SJohnston95/2.4Ghz-SMD-filter/20180318_172855.jpg

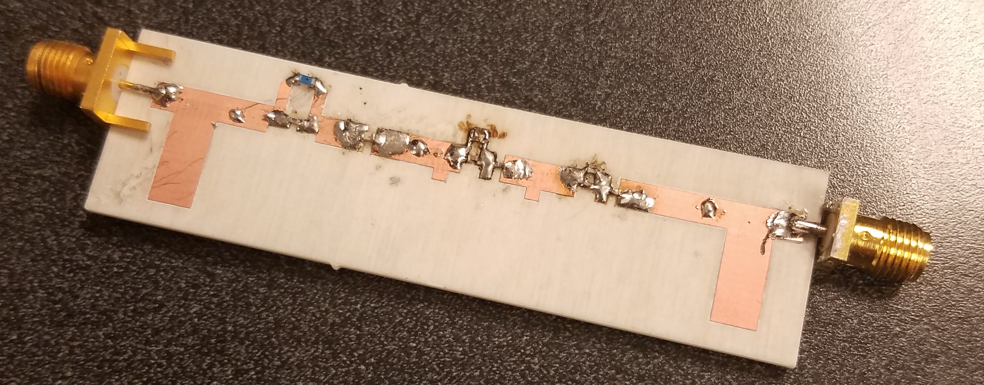
20180318_172855.jpg
