SJohnston95/2.4Ghz-SMD-filter/Pyle_Johnston_Zodrow_ECE431_Filter_Paper_Final.pdf

ECE 431/531 Winter 2018 Final Project Mitch Pyle
Stephen Johnston
Dylan Zodrow
Characterizing the Substrate

In order to design a great filter in the microwave spectrum small details become increasingly important. A distributed element filter relies heavily on the characteristics of the substrate. Thankfully using ADS we can model these characteristics and change them easily. There are many options in ADS, but the basic simulation in ADS requires us to know the conductivity, height, thickness and relative permittivity.

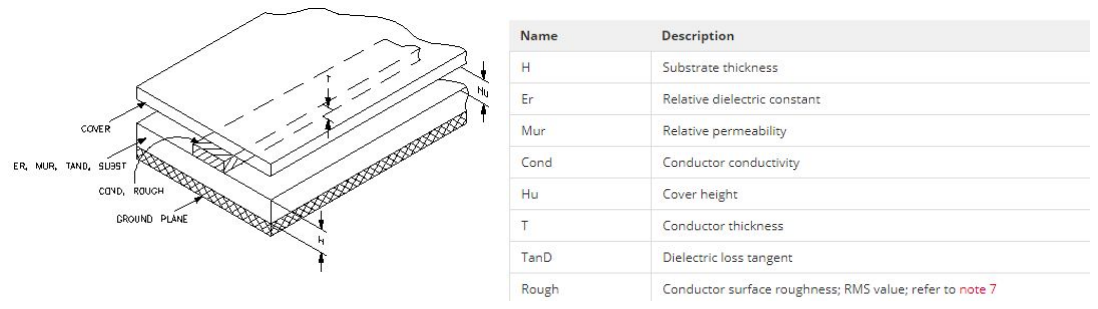
[picture p2: figure]

Figure 1 – ADS MSub Parameters[5]

Fortunately the sample we obtained from Rogers Corporation has a very detailed datasheet. [6]

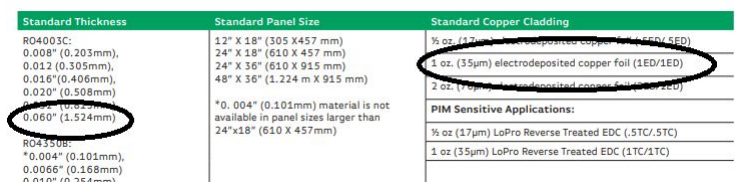
[picture p3: figure]

Figure 2 – Rogers R04003C Datasheet

Figure 3- Properties of Copper [3][4]

Design, Build, and Test Calibration Structures

Many of the characteristics of the substrate can be obtained from the datasheet, but as engineers we need to know how these characteristic information is obtained. Using ADS we will attempt to make our own estimate of the relative permittivity of our substrate. Using a parallel distributed element structure we will see some dramatic changes in the S21 at specific frequencies. Simulating the circuit and measuring the circuit with the VNA should give us an estimate of the actual effective permittivity.

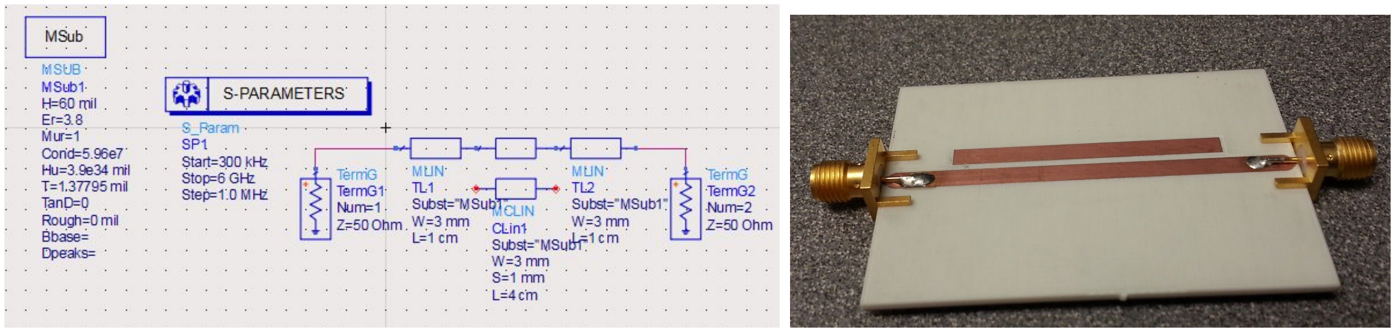
[picture p4: figure]

Figure 4- ADS Simulation and Actual Parallel Resonant Circuit

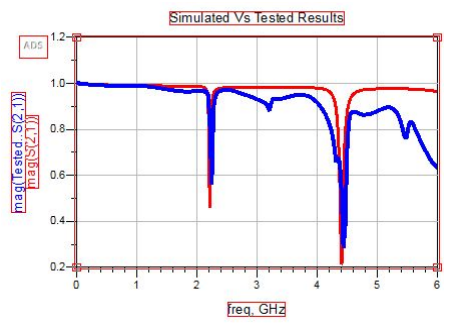
[picture p5: figure]

Figure 5- Measured and Simulated Results

TRL Calibration Board Design

All measurements will be done using a Vector Network Analyzer (VNA), which requires calibration prior to taking measurements. Proper calibration of the VNA requires the use of three references: Through, reflect, and line (TRL). The through connection is the two SMA terminals connected by a small transmission line, this is normalization reference. The reflect connection consists of two SMA connectors with a gap of λ/4, or at 1 GHz in a copper trace about 22.8 mm. The line connection consists of two SMA connectors connected by a λ/4 section of TL line.

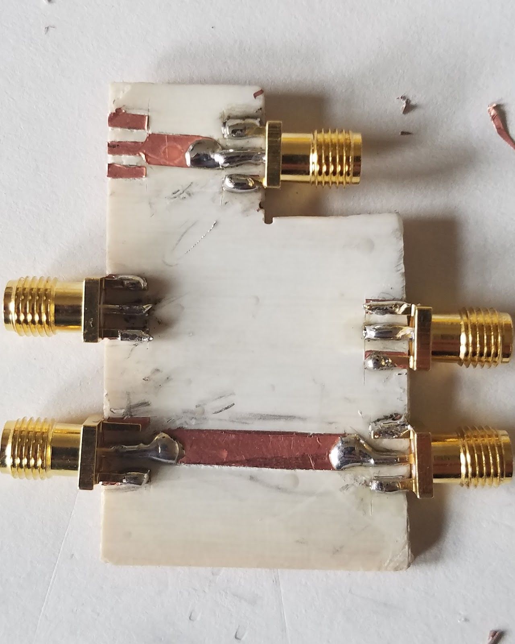
[picture p6: figure]

Figure 7- Constructed TRL Board (Mostly complete)

Clearly, since measurements are given in terms of λ, a TRL Board is only good for a given frequency, ior small range. Once the board is constructed, the calibration is performed by defining a Cal Kit in the VNA software. This is done by defining the frequency range of measurement and assigning the through, reflect, and line measurements. For each connection all 4 S parameters are measured, and using these 12 measurements the VNA uses a set of equations to calculate 10 of the 12 error (it not being possible to calculate the forward and the reverse isolations terms with the available data). With these numbers saved as a Cal Kit, it is then possible to apply these settings when taking a measurement of, say, a filter design.

“Paper” Design

The only requirement for our filter is the graph below. Looking at the graph we can see that the insertion loss should be -4dB at the center frequency of 2.6 or 2.4 GHz. It is important to also notice that both filters have a roll-off of 40 dB for 100 MHz on either side. I would also venture to say that the filter has a perfectly flat passband for 100 MHz around the center frequency.

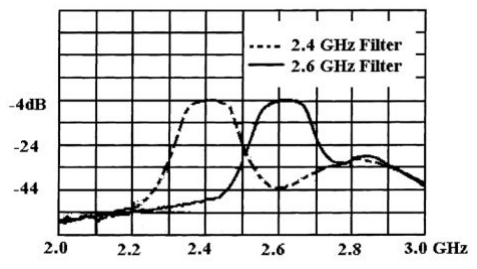
[picture p7: figure]

Figure 8- Filter Requirements

Distributed Element Filter

Designing the distributed element filter was greatly facilitated by ADS. I had seen pictures of similar filters [7] and knew I would need a parallel resonant element. I initially used a single element and 50 ohm strips to solder on the connections. I used ADS’s tuning option to fit the length, width, and separation to our desired frequency range with a single element. This gave me a filter with a very large bandpass. The roll-off was not enough with a single element. I added more elements in series effectively adding more stages and increasing the roll-off.

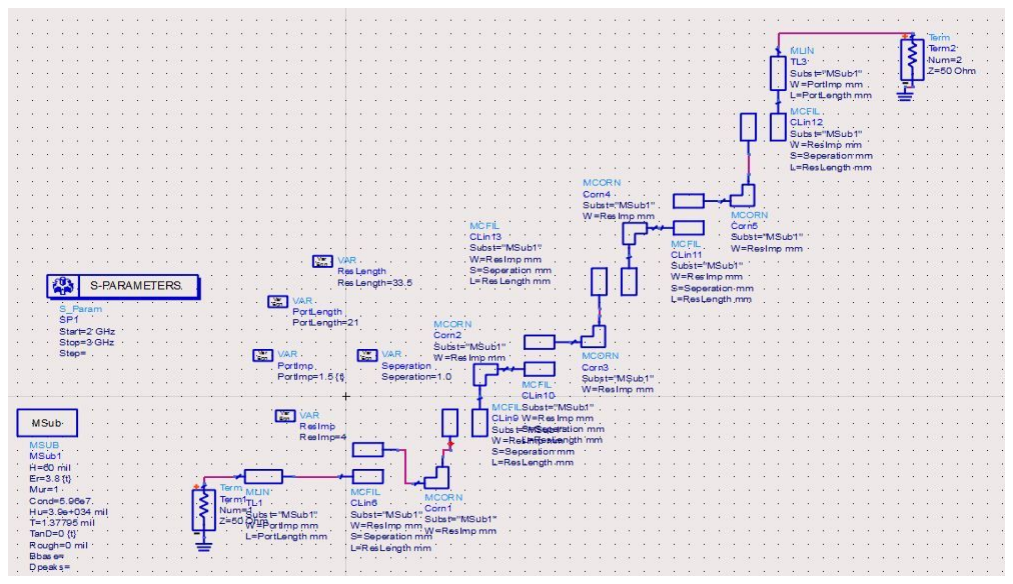
[picture p8: figure]

Figure 9- ADS Simulation of the Distributed Element Filter

My initial success was far too large to print on one sample of substrate. I used corner pieces in an effort to make my design more compact. As you can see from the figure below I tuned the whole circuit with a handful of variables. I knew it would be hard to realize, so I only incremented things in .5 millimeter increments. After hours of tuning I came up with my final design. A very simple design that could be cut by hand. The smallest measurement was 1.5 mm.

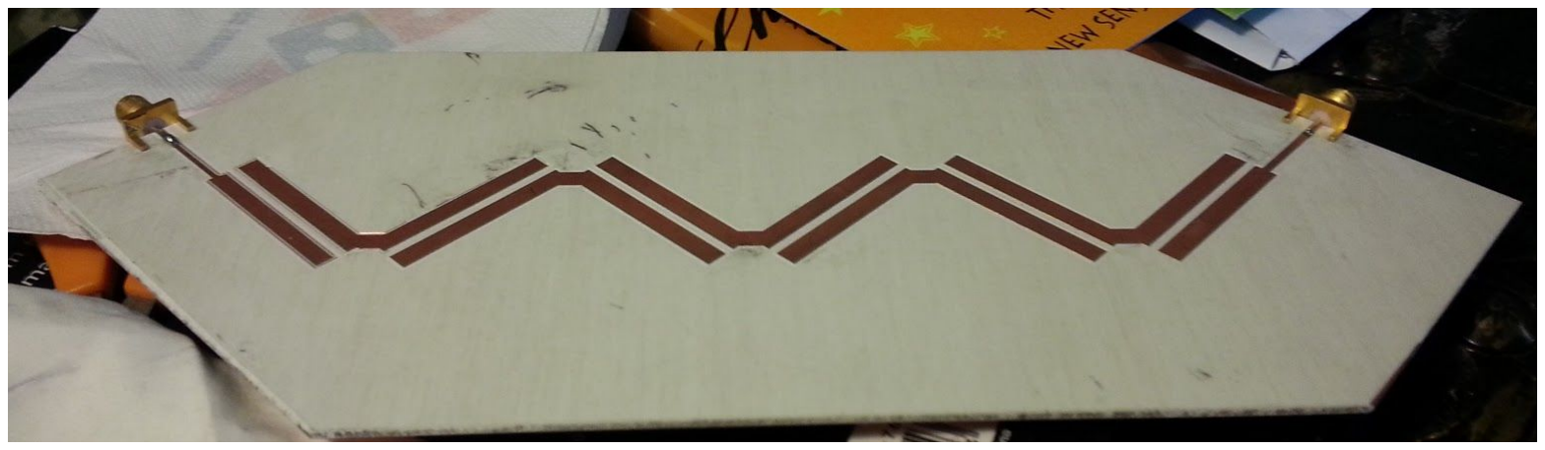
[picture p9: figure]

Figure 10- The Final Distributed Element Circuit

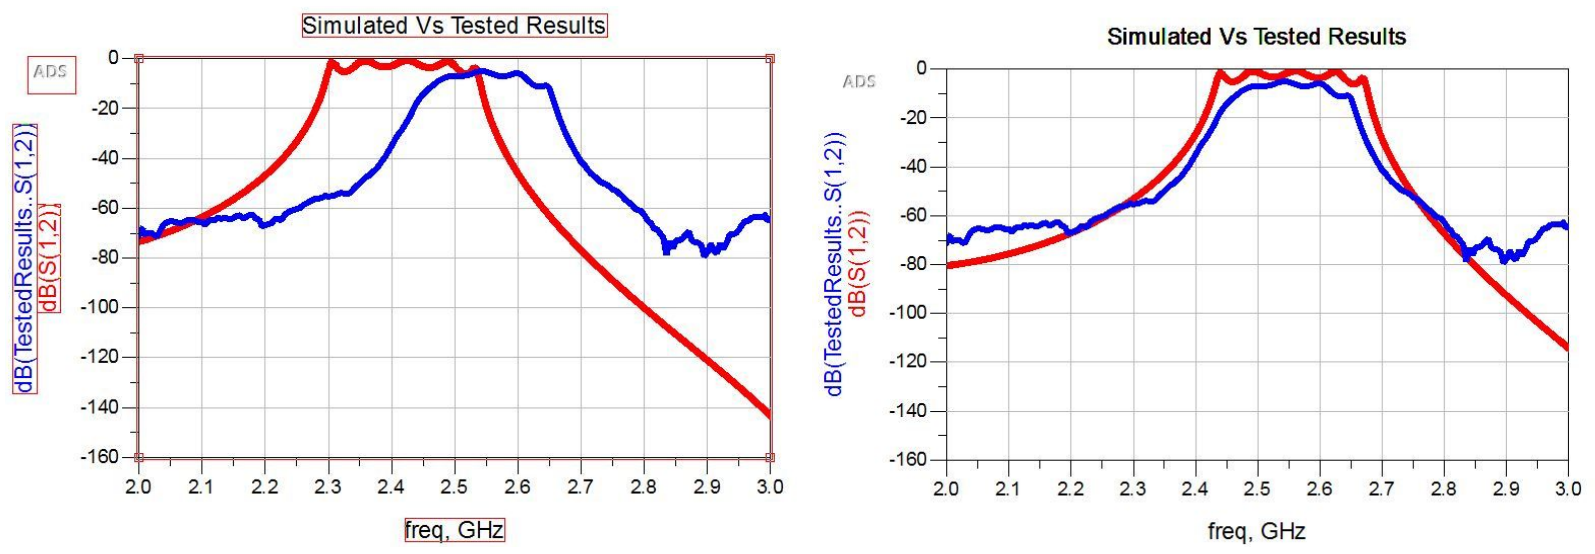
[picture p10: figure]

Figure 9- Comparison of Tested and Simulated Results and Adjusted Effective Permittivity

Results

Again using ADS i was able to discover the largest difference between simulation and reality. I used the tuning feature of ADS to adjust the Er of my substrate to 3.3 and the outputs were nearly identical. The insertion loss may be due to the input terminal strips a bit less than 50 ohms. I made them this way intentionally because it seemed to improve insertion loss in the simulation. Also a router issue made one input terminal strip just a tiny bit smaller than the other. The next prototype would be much closer to the expected result. An Er of 3.3 is close to the datasheet specs from Rogers as well.

SMD filter

When the filter was first designed, we followed the standard chebyshev design process. First we design the equivalent low pass filter, determining the cutoff frequency, attenuation and necessary components. Then we convert it into a bandpass filter with the equations listed below.

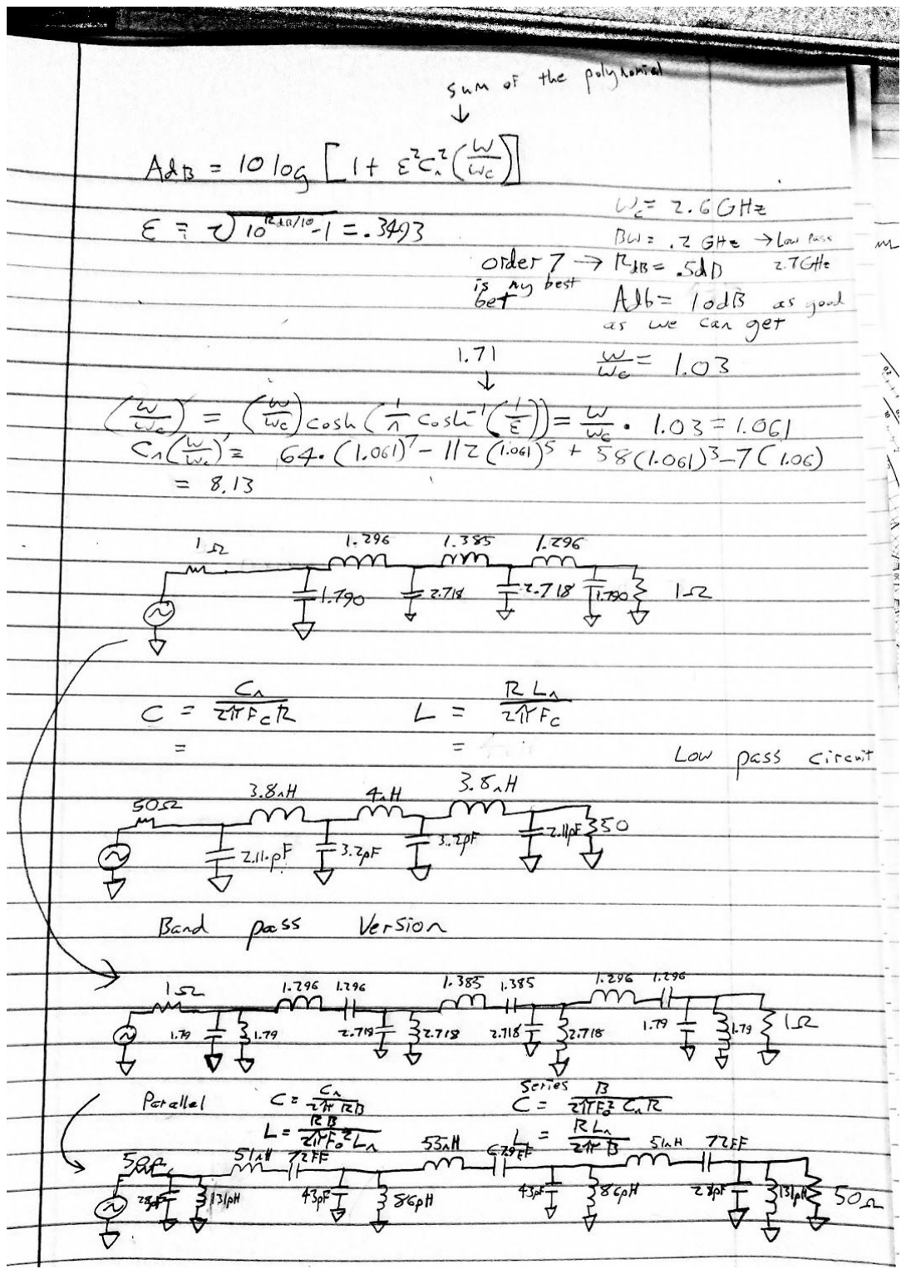
[picture p11: figure]

Figure 11- Paper Calculations for the SMD 2.6 GHz Filter

Figure 12- ADS Initial SMD Filter Simulation

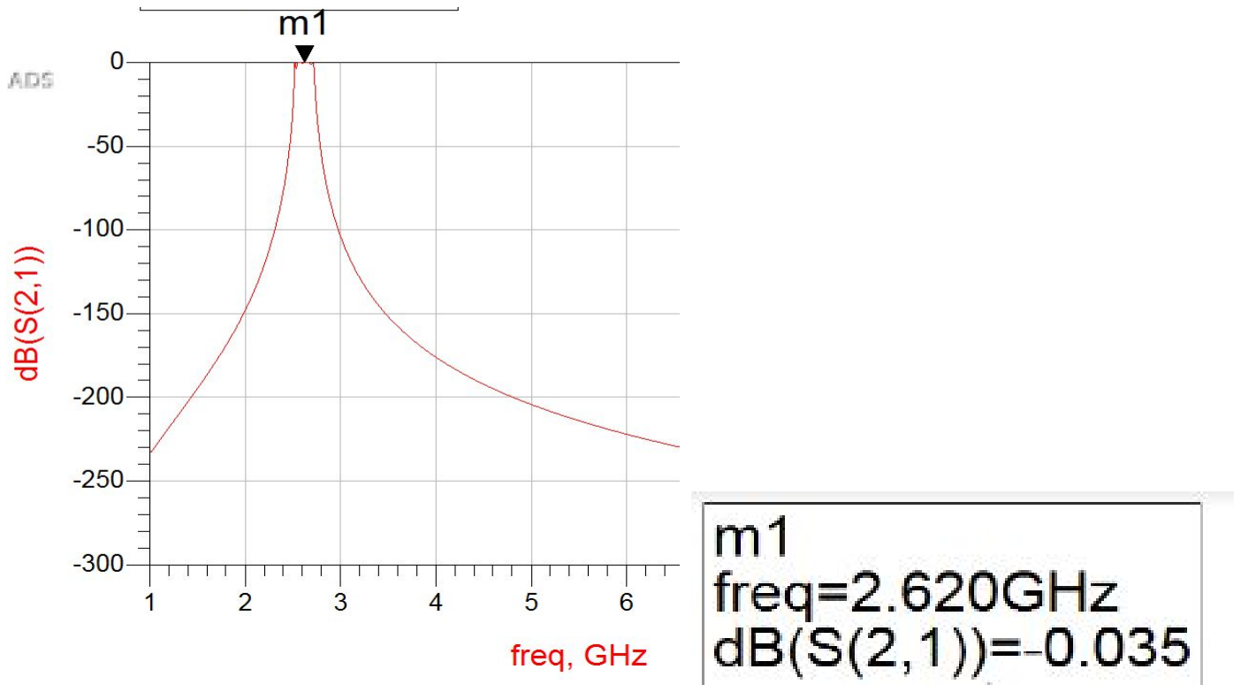
[picture p12: figure]

Figure 13- Results of Initial SMD Filter Simulation

But the problem is that these components don’t actually exist. Nothing is perfect and circuits are no exception, we need more accurate simulations before we can build anything of this magnitude.

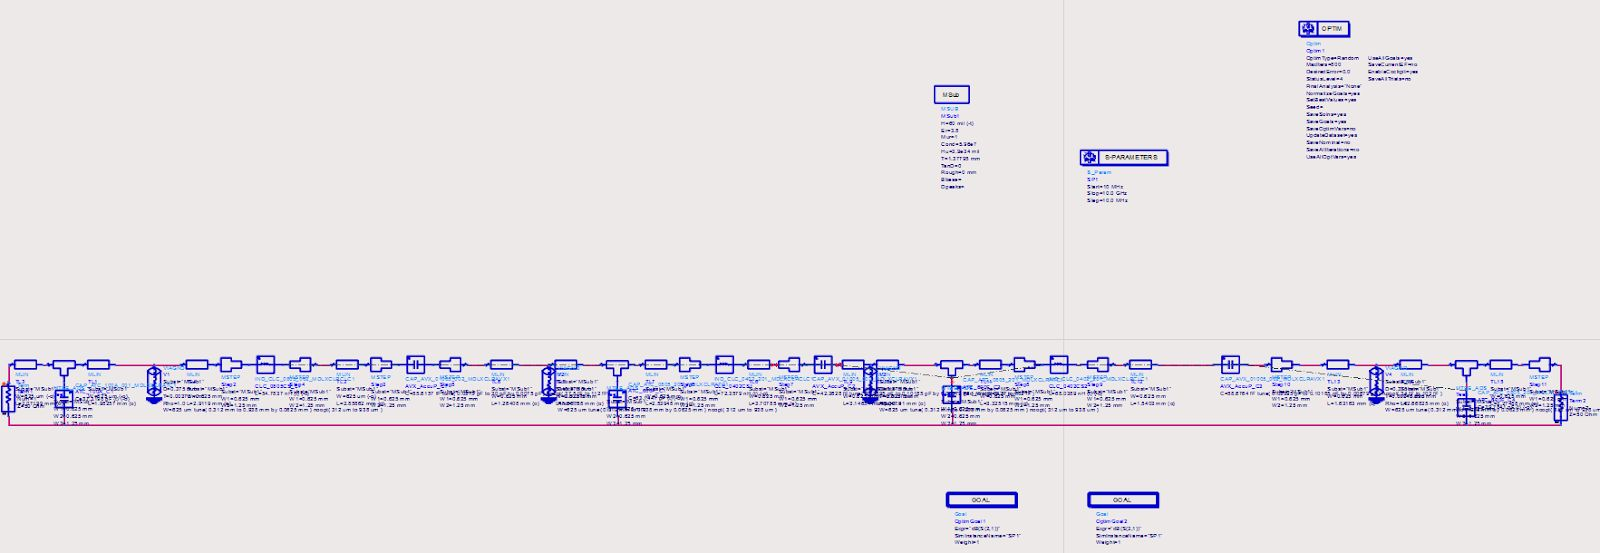
[picture p13: figure]

Figure 14- ADS SMD Filter Simulation with Added Microstrip Pads and Connections

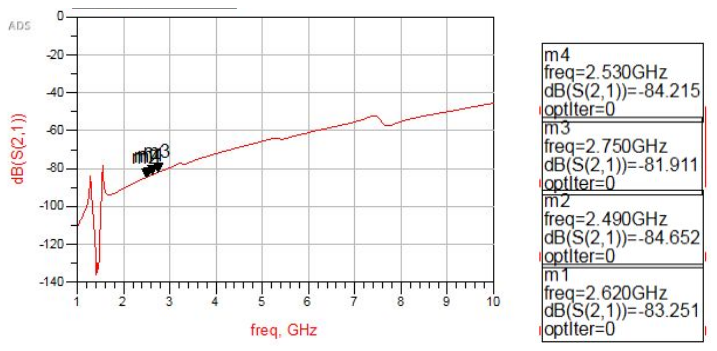
[picture p14: figure]

Figure 15- ADS Results

EVERYTHING IS RUINED. Unfortunately so. Our band pass filter that worked so perfectly under perfect conditions broke at the sign of stress. Luckily, we have an option. We can remove unreliable
components such as small inductors or capacitors to ground and replace them with vias and open circuit stubs, respectively. And run the optimization function, sometimes for hours. Until the response slowly and surely begins to look more and more like a filter

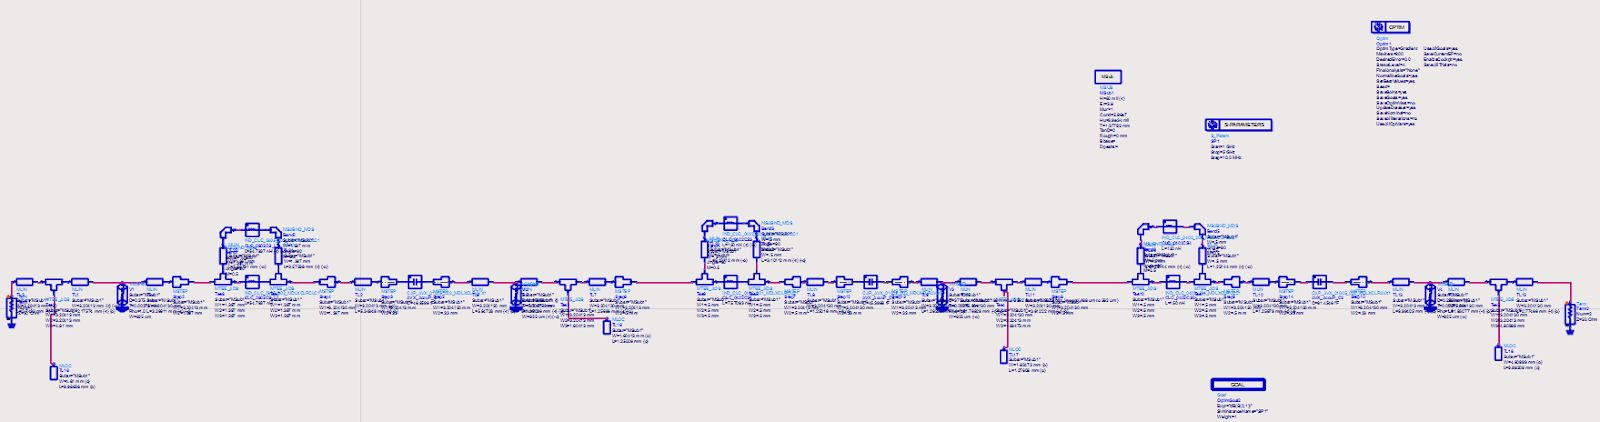
[picture p15: figure]

Figure 17- ADS Simulation of Distributed Element / SMD Hybrid

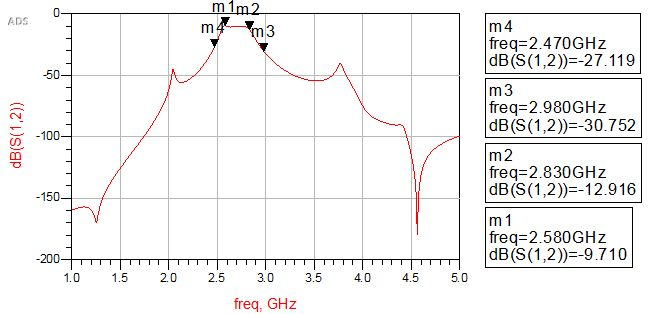
[picture p16: figure]

Figure 18- ADS Results of Distributed Element / SMD Hybrid

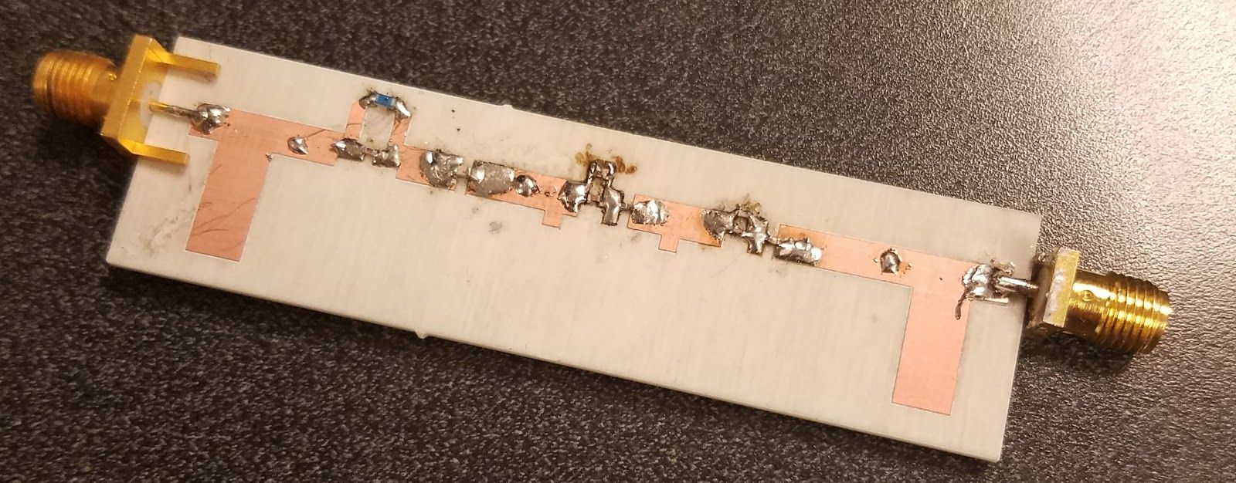
[picture p17: figure]

Figure 19- Realized SMD Filter

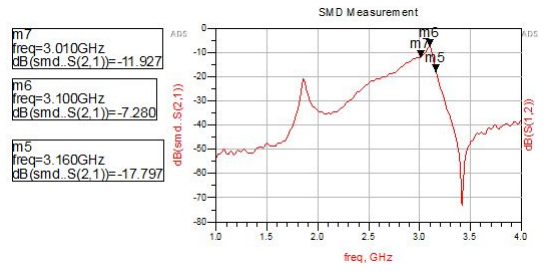
[picture p18: figure]

Figure 20- s(2,1) of the SMD Filter

Our output was not at all what we were hoping for. Due to the fact that the filter responds in the general frequency range, we have a large degree of hope for improvement. Possible failures include but definitely are not limited to

- SMD burn out
- Inexact substrate characterization
- Inexact conductivity of the copper and routing errors
- Solder improperly compensated for
- SMDS soldered on and not using a reflow oven

Further plans include compensating for SMD inductance by having more small open circuit stubs next to the component. This is because we can easily shave the stubs off to get the exact compensation for our SMD inductance. Other plans are using reflow ovens to exactly solder on with the least amount of solder.

References

[1]
C. Furse, R.J. Woodward, M.A. Jensen, “Laboratory Project in Wireless FSK Receiver Design,” IEEE Trans. Education, Vol. 47, no. 1, pp. 18-25, Feb. 2004.

[2]
Modelithics applications notes #17 “APPLICATION NOTE 017 “LUMPED ELEMENT FILTER DESIGN AND OPTIMIZATION”, #20 “LUMPED ELEMENT BAND-PASS FILTER DESIGN AND OPTIMIZATION.” Available at http://www.modelithics.com/literature.asp

[3]
Wikipedia “Permeability (Electromagnatism)” Available at https://en.wikipedia.org/wiki/Permeability_(electromagnetism)

[4]
Wikipedia “Electrical Resistivity and Conductivity” Available at https://en.wikipedia.org/wiki/Electrical_resistivity_and_conductivity

[5]
Keysights Technologies “MSUB (Microstrip Substrate)” Available at http://edadocs.software.keysight.com/pages/viewpage.action?pageId=5912136

[6]
Rogers Corporation “R04000 Laminates Data Sheets” Available at https://www.rogerscorp.com/acs/products/54/RO4003C-Laminates.aspx

[7]
Wikipedia “Distributed Element Filter” Available at https://en.wikipedia.org/wiki/Distributed_element_filter

[8]
Copper Mountain Technologies,”Fabricating and Using a PCB-Based TRL PAttern with aCMT VNA”, https://www.coppermountaintech.com/content/docs/library/Design_and_Fabrication_of_a_TRL_calibration_kit.pdf

[9]

Fleury, J. and Bernard, O. California Eastern Laboratories, “Design and Characterizing TRL Fixture Calibration Standards for Device Modeling”, http://www.cel.com/pdf/press/TRL.pdf
