SJohnston95/2.4Ghz-SMD-filter/20180303-163044_p0.jpg

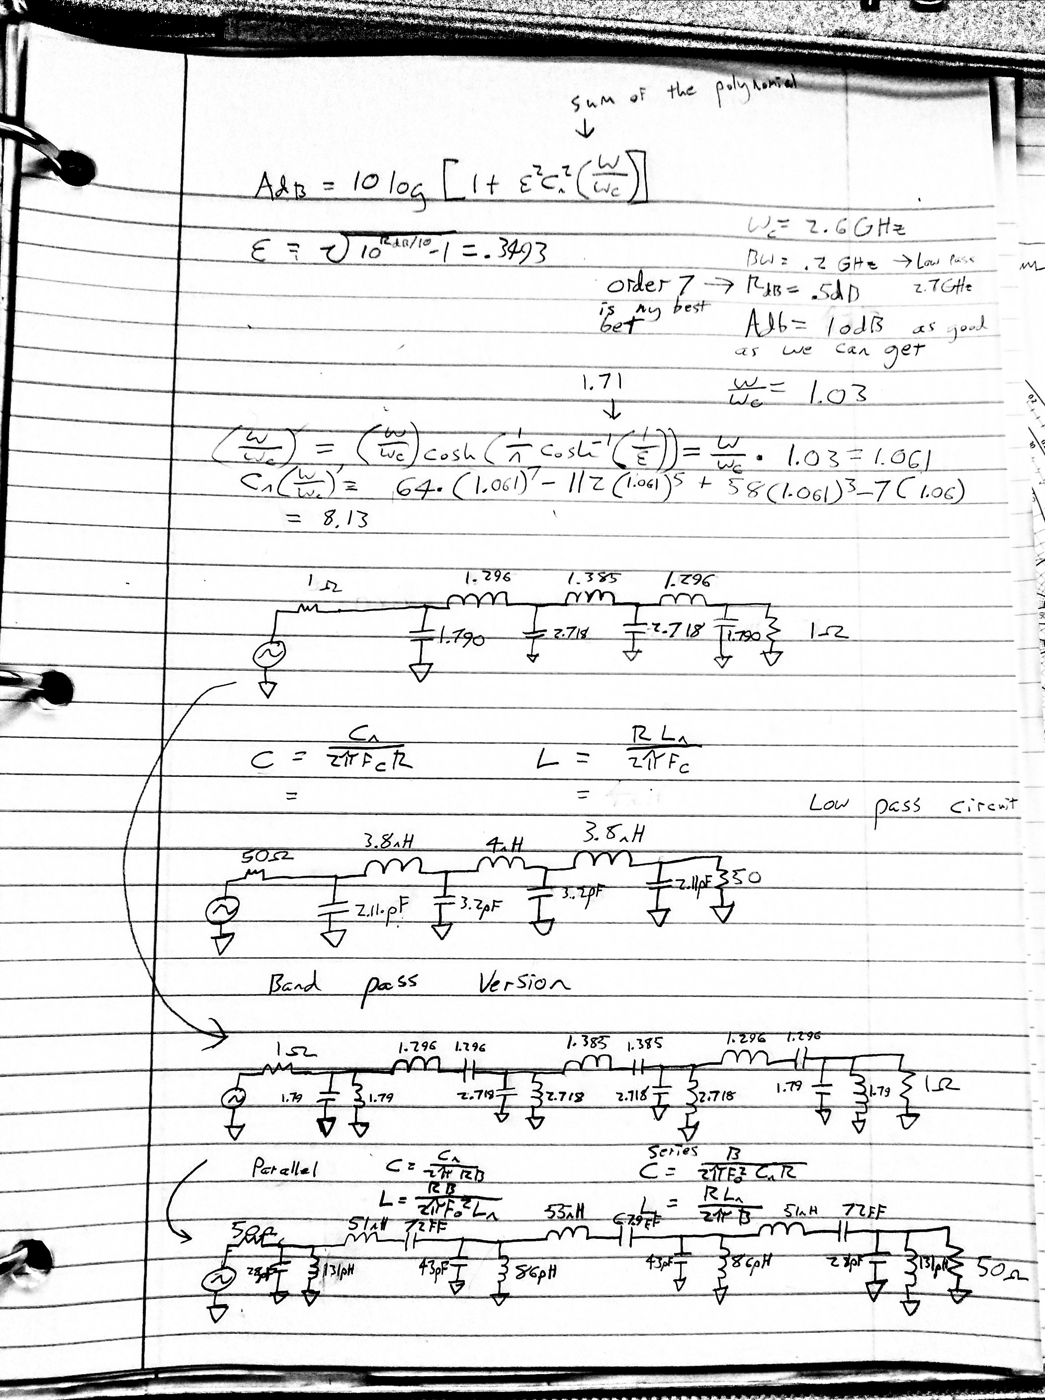
20180303-163044_p0.jpg
