SJohnston95/2.4Ghz-SMD-filter/filter.PNG

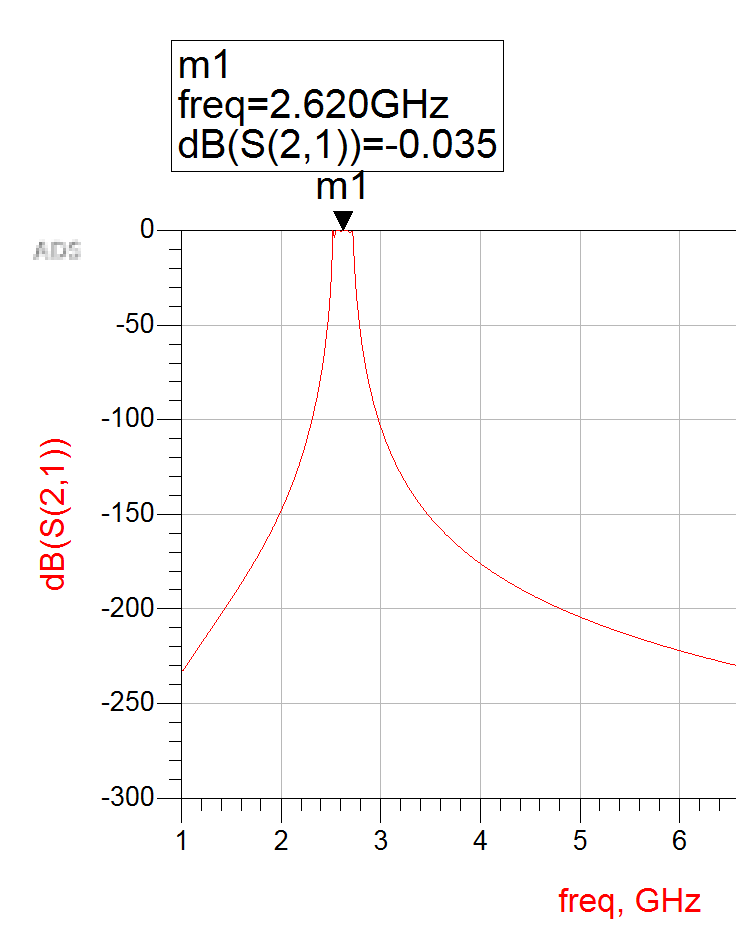
filter.PNG
