SJohnston95/2.4Ghz-SMD-filter/Filtersparam.PNG

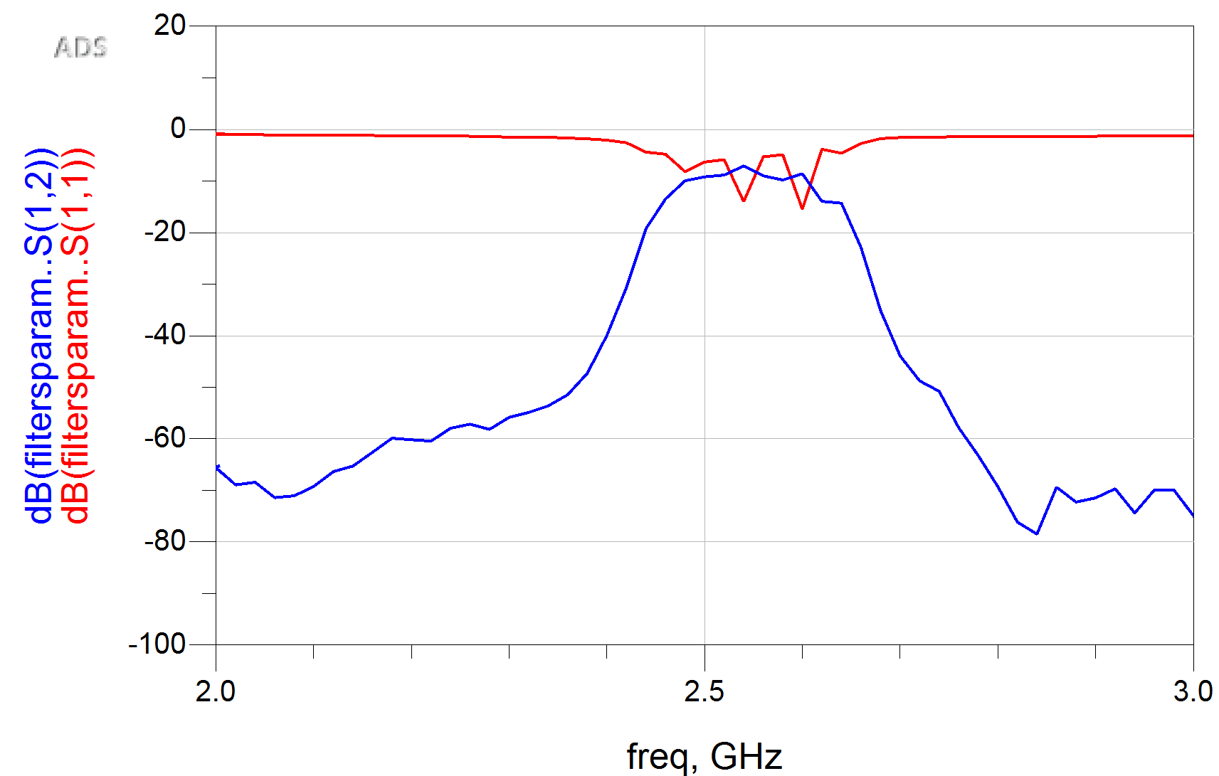
Filtersparam.PNG
