SJohnston95/2.4Ghz-SMD-filter/modellithicsdesign.PNG

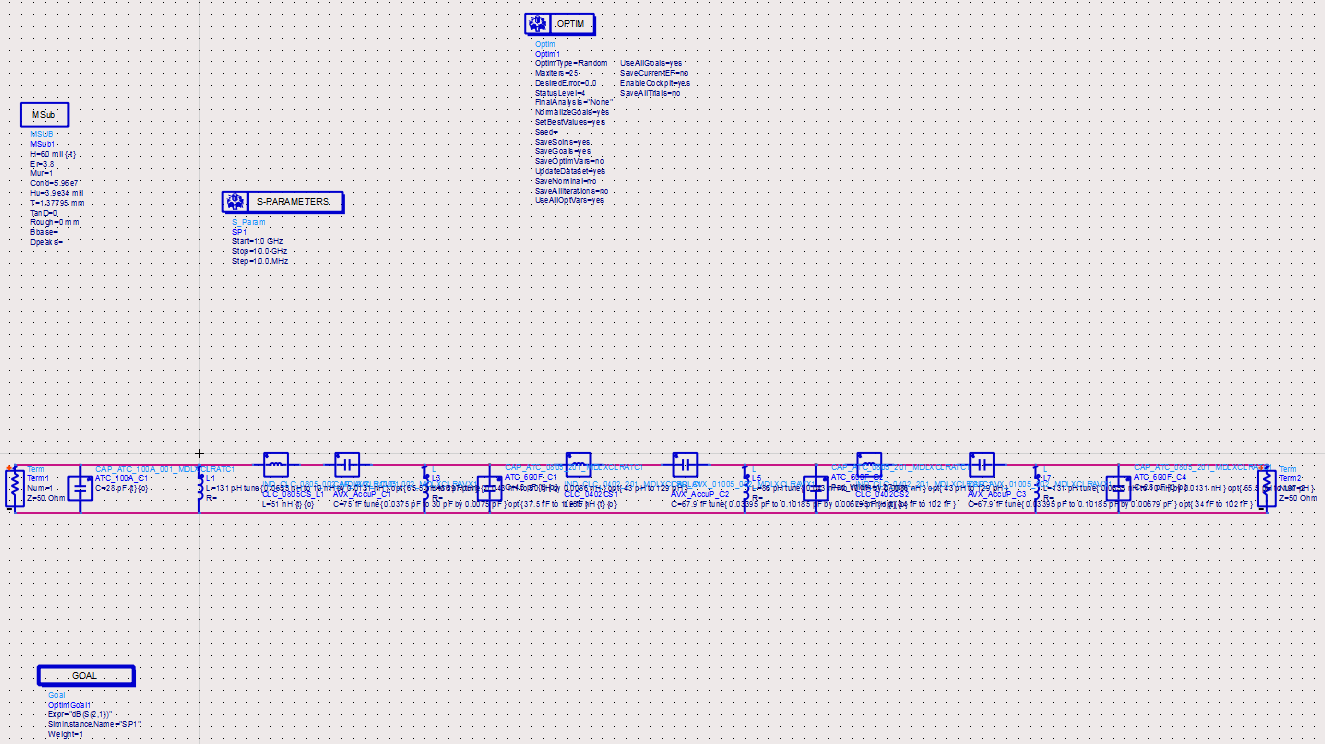
modellithicsdesign.PNG
