SJohnston95/2.4Ghz-SMD-filter/postoptimization_Out.PNG

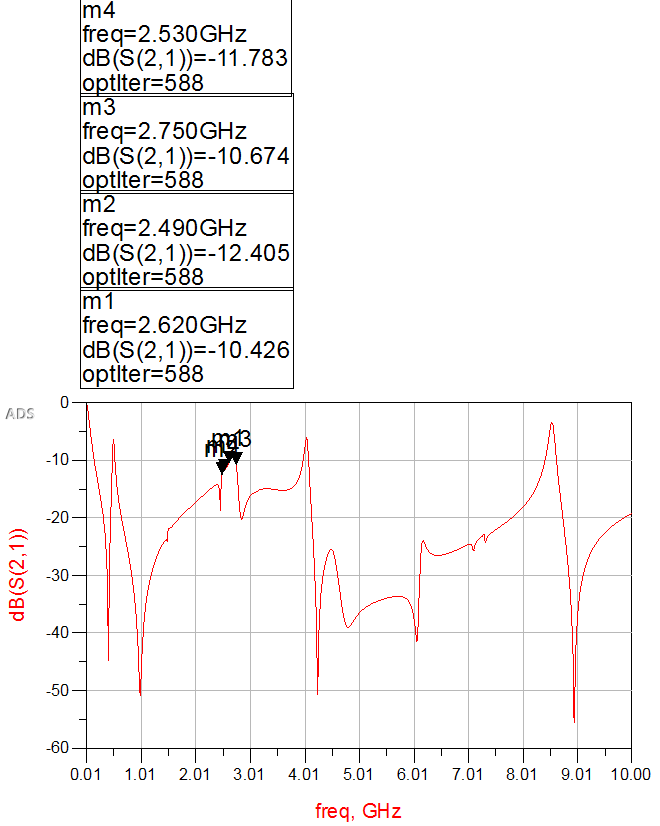
postoptimization_Out.PNG
