SJohnston95/2.4Ghz-SMD-filter/preoptimizationS(2,1).PNG

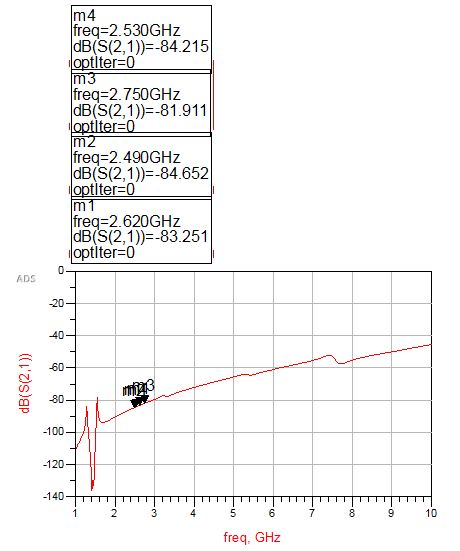
preoptimizationS(2,1).PNG
