SJohnston95/2.4Ghz-SMD-filter/SMDoutput.PNG

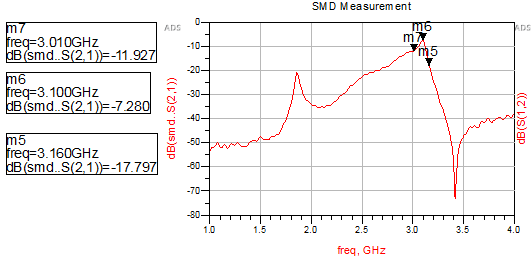
SMDoutput.PNG
