SJohnston95/2.4Ghz-SMD-filter/througholeout.PNG

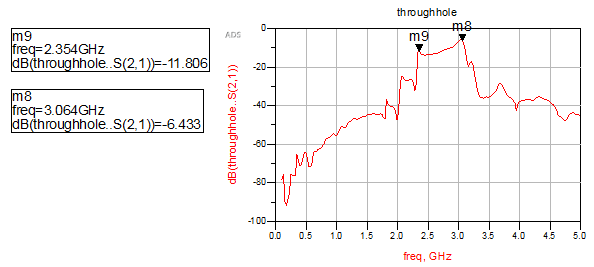
througholeout.PNG
